ivatt260/DCC_XpressNet_Throttle/PotSwitchThrottle-inside.JPG

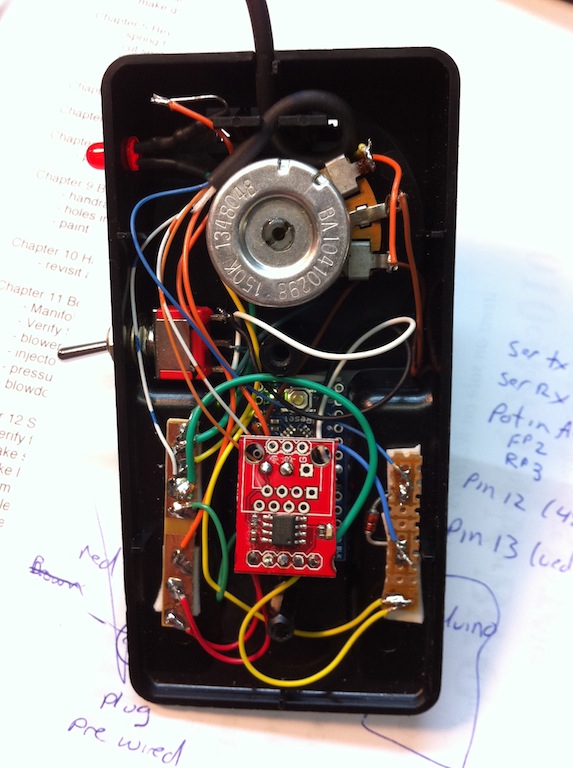
PotSwitchThrottle-inside.JPG
