ivatt260/DCC_XpressNet_Throttle/IMG_3793.jpeg

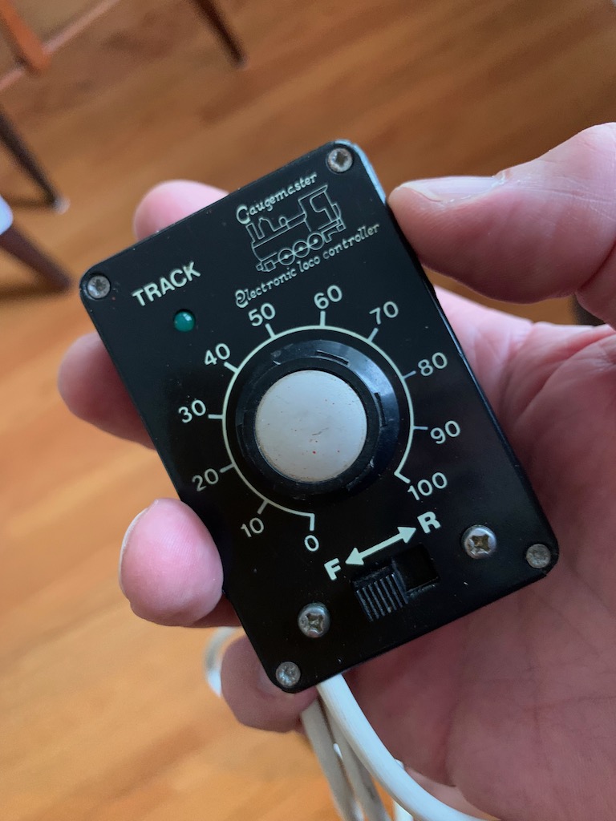
IMG_3793.jpeg
