ivatt260/DCC_XpressNet_Throttle/IMG_3790.jpeg

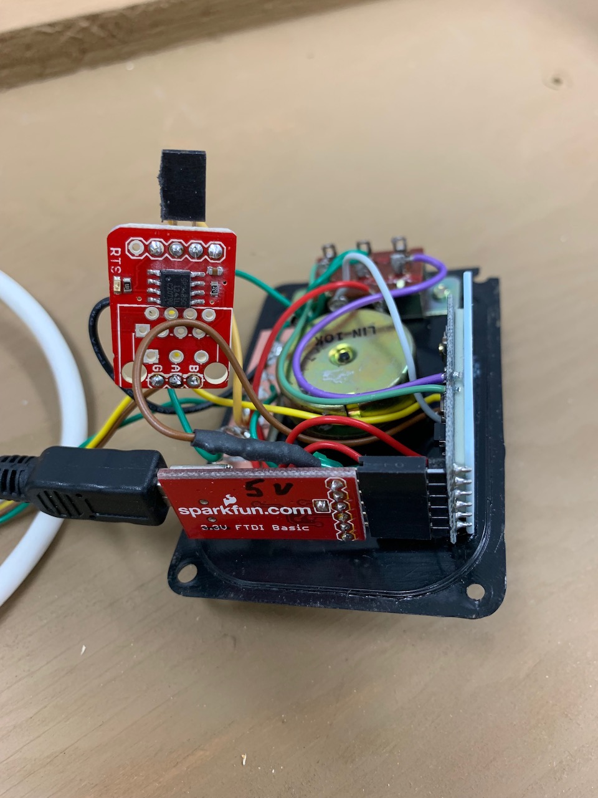
IMG_3790.jpeg
