ivatt260/DCC_XpressNet_Throttle/IMG_3792.jpeg

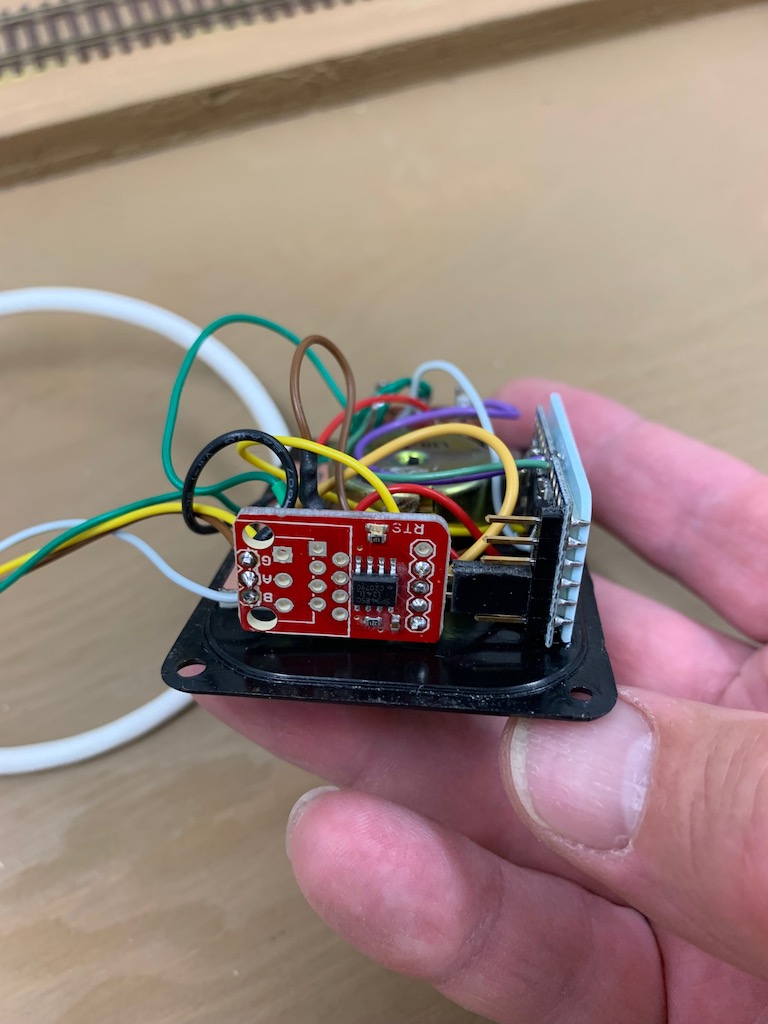
IMG_3792.jpeg
