ivatt260/DCC_XpressNet_Throttle/PotSwitchThrottle-outside.JPG

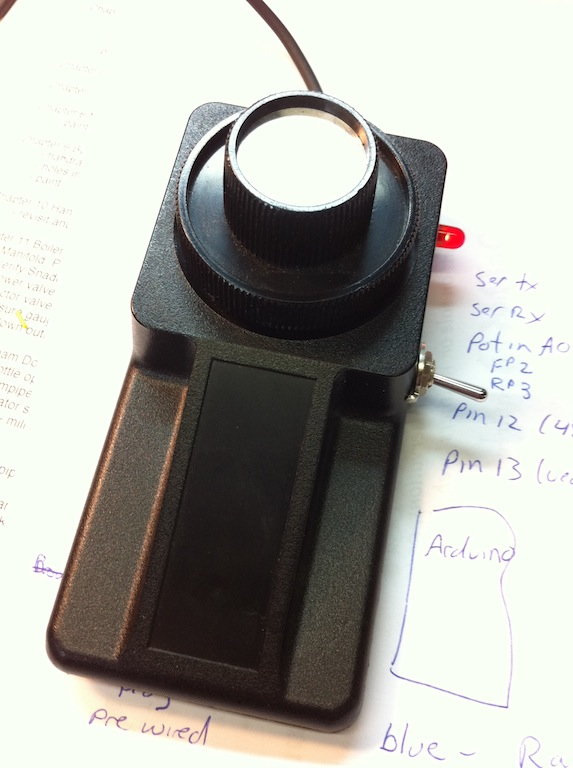
PotSwitchThrottle-outside.JPG
