ivatt260/DCC_XpressNet_Throttle/(commit log)

2023-06-08 Arduino Sketch for XPressnet DCC Throttles
    The Arduino Sketch - Changed some #defines to make it easier to read, and removed some old debug code.
    Added pictures; modified an old "Gaugemaster" throttle to DCC
2024-03-28 Update README.md
    Added 3.3v, and ESTOP.
2024-03-28 Updated code to add an ESTOP button.
    Gives a good framework for letting you add more buttons (toggle switch or pushbutton) if you wish.
    This code continues to work, but once or twice, I really wanted an ESTOP button in my hand! My wish is my command, and it appeared. :-)
